sparques/mohawk/mohawk/mohawk.kicad_pcb

## KiCad design mohawk/mohawk.kicad_pcb (2026-11-03)

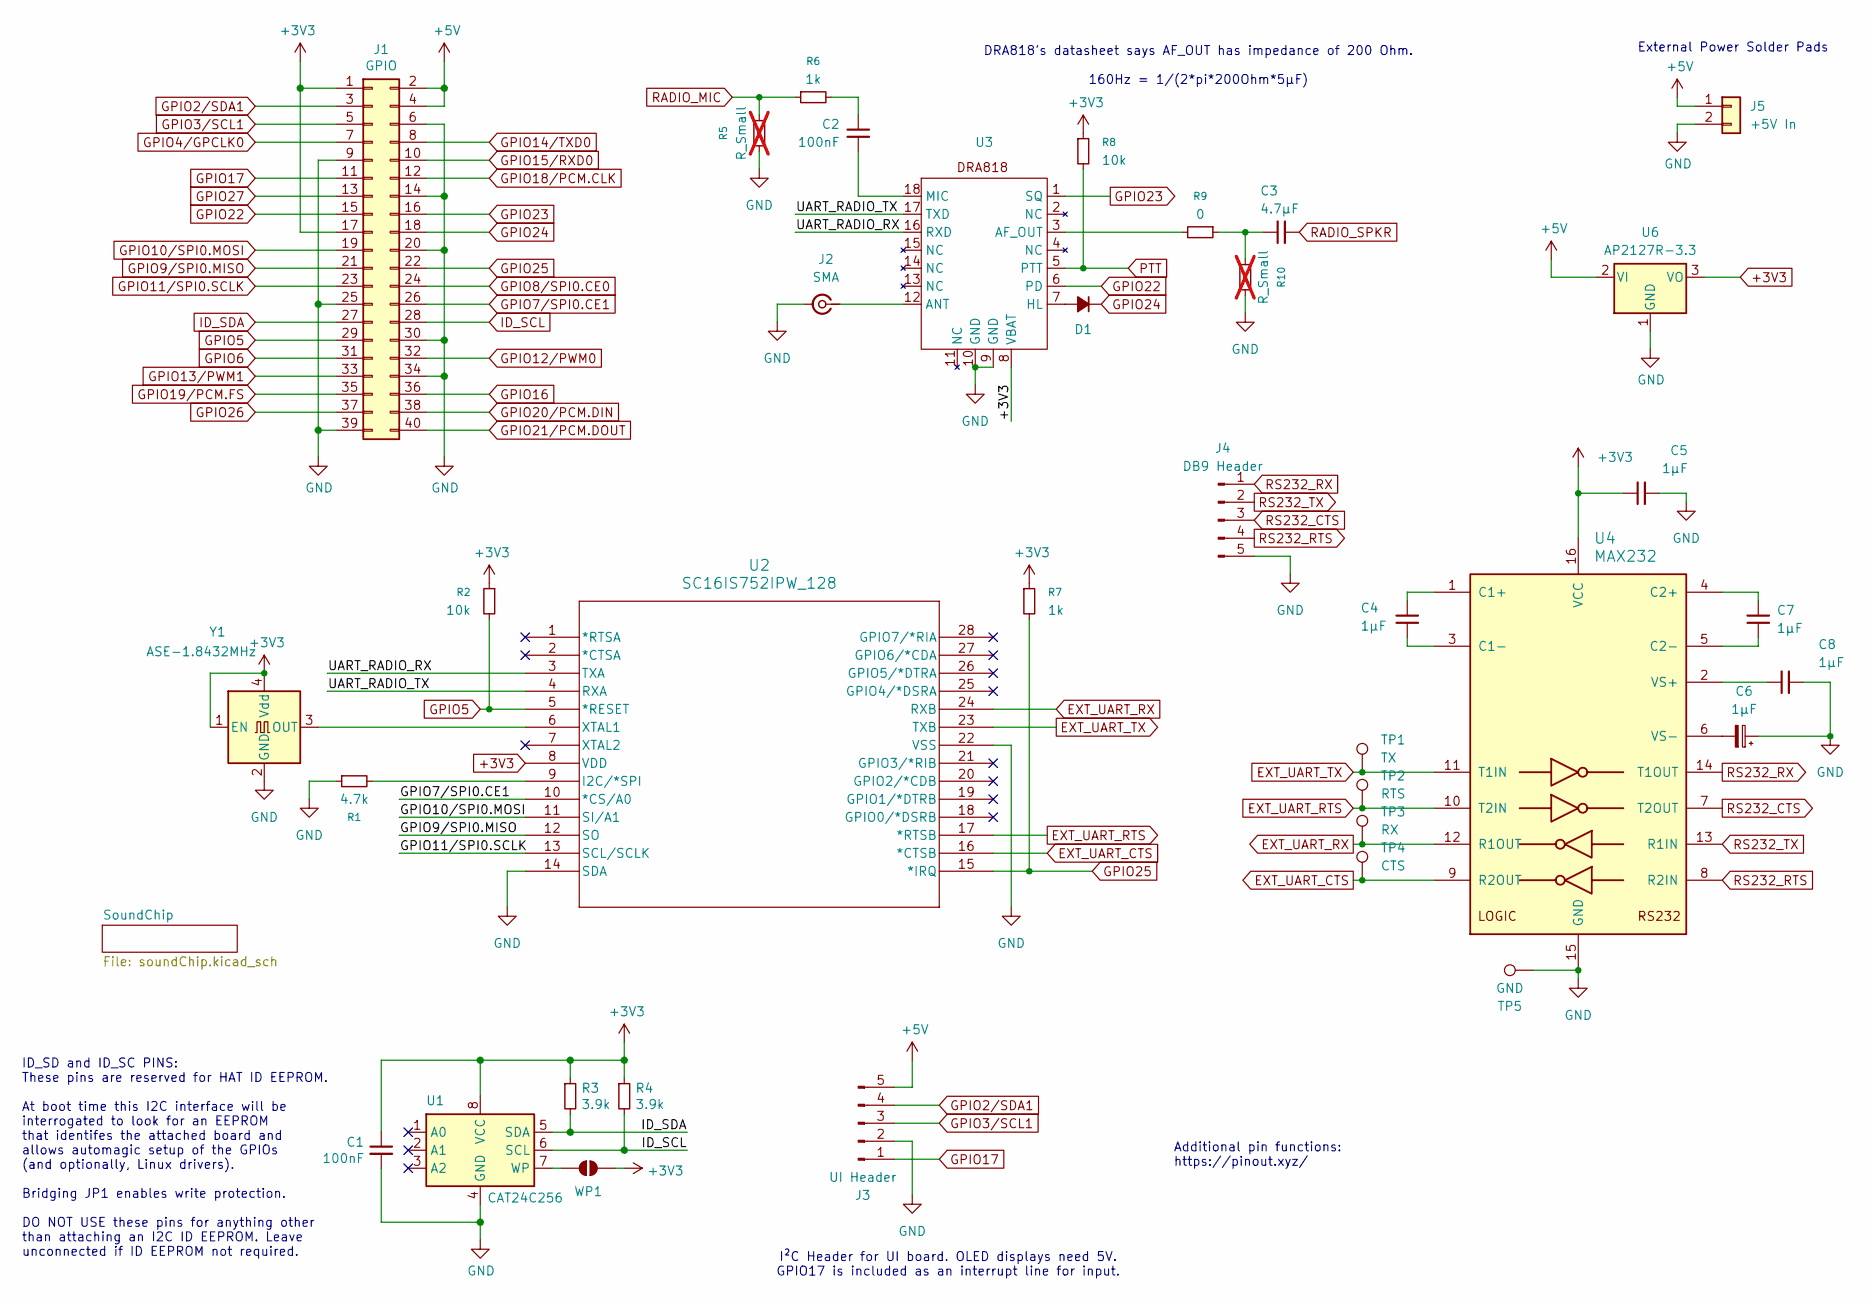
[picture p3: schematic mohawk.kicad_sch]

Parts:
C1, C2: 100nF; C_0805_2012Metric
C3: 4.7µF; C_0805_2012Metric
C4, C5, C6, C7, C8: 1µF; C_0805_2012Metric
D1: D_0805_2012Metric
J1: GPIO; PinSocket_2x20_P2.54mm_Vertical
J2: SMA; SMA_BAT_Wireless_BWSMA-KWE-Z001
J3: UI Header; 1x05 SMD pads
J4: DB9 Header; 1x05 SMD pads
J5: +5V In; SolderWirePad 1x02
R1: 4.7k; R_0805_2012Metric
R2, R8: 10k; R_0805_2012Metric
R3, R4: 3.9k; R_0805_2012Metric
R5, R10: R_Small; R_0805_2012Metric; not fitted
R6, R7: 1k; R_0805_2012Metric
R9: 0; R_0805_2012Metric
TP1: TX; TestPoint_Pad_D1.0mm
TP2: RTS; TestPoint_Pad_D1.0mm
TP3: RX; TestPoint_Pad_D1.0mm
TP4: CTS; TestPoint_Pad_D1.0mm
TP5: GND; TestPoint_Pad_D1.0mm
U1: CAT24C256; SOIC8_ONS
U2: SC16IS752IPW_128; TSSOP28_SOT361-1_NXP
U3: DRA818
U4: MAX232; PW16
U6: AP2127R-3.3; SOT-89-3
WP1: ID_WP; SolderJumper-2_P1.3mm_Open_Pad1.0x1.5mm
Y1: ASE-1.8432MHz; Oscillator_SMD_Abracon_ASE-4Pin_3.2x2.5mm

Connections:
+3V3: C1.1, C5.2, J1.1, J1.17, R2.1, R3.1, R4.1, R7.1, R8.1, U1.8 (VCC), U2.8 (VDD), U3.8 (VBAT), U4.16 (VCC), U6.3 (VO), WP1.2 (B), Y1.1 (EN), Y1.4 (Vdd); also elsewhere on the board
+5V: J1.2, J1.4, J3.5, J5.1, U6.2 (VI)
/UART_RADIO_RX: U2.3 (TXA), U3.16 (RXD)
/UART_RADIO_TX: U2.4 (RXA), U3.17 (TXD)
EXT_UART_CTS: TP4.1 (1_1), U2.16 (*CTSB), U4.9 (R2OUT)
EXT_UART_RTS: TP2.1 (1_1), U2.17 (*RTSB), U4.10 (T2IN)
EXT_UART_RX: TP3.1 (1_1), U2.24 (RXB), U4.12 (R1OUT)
EXT_UART_TX: TP1.1 (1_1), U2.23 (TXB), U4.11 (T1IN)
GND: C1.2, C5.1, C6.1, C8.2, J1.6, J1.9, J1.14, J1.20, J1.25, J1.30, J1.34, J1.39, J2.2 (Ext), J3.2, J4.5, J5.2, R1.1, R5.1, R10.1, TP5.1 (1_1), U1.4 (GND), U2.14 (SDA), U2.22 (VSS), U3.9 (GND), U3.10 (GND), U4.15 (GND), U6.1 (GND), Y1.2 (GND); also elsewhere on the board
GPIO2/SDA1: J1.3, J3.4
GPIO3/SCL1: J1.5, J3.3
GPIO4/GPCLK0: J1.7; also elsewhere on the board
GPIO5: J1.29, R2.2, U2.5 (*RESET)
GPIO6: J1.31
GPIO7/SPI0.CE1: J1.26, U2.10 (*CS/A0)
GPIO8/SPI0.CE0: J1.24; also elsewhere on the board
GPIO9/SPI0.MISO: J1.21, U2.12 (SO); also elsewhere on the board
GPIO10/SPI0.MOSI: J1.19, U2.11 (SI/A1); also elsewhere on the board
GPIO11/SPI0.SCLK: J1.23, U2.13 (SCL/SCLK); also elsewhere on the board
GPIO12/PWM0: J1.32
GPIO13/PWM1: J1.33
GPIO14/TXD0: J1.8
GPIO15/RXD0: J1.10
GPIO16: J1.36
GPIO17: J1.11, J3.1
GPIO18/PCM.CLK: J1.12; also elsewhere on the board
GPIO19/PCM.FS: J1.35; also elsewhere on the board
GPIO20/PCM.DIN: J1.38; also elsewhere on the board
GPIO21/PCM.DOUT: J1.40; also elsewhere on the board
GPIO22: J1.15, U3.6 (PD)
GPIO23: J1.16, U3.1 (SQ)
GPIO24: D1.1 (K), J1.18
GPIO25: J1.22, R7.2, U2.15 (*IRQ)
GPIO26: J1.37
GPIO27: J1.13; also elsewhere on the board
ID_SCL: J1.28, R4.2, U1.6 (SCL)
ID_SDA: J1.27, R3.2, U1.5 (SDA)
unnamed: C2.1, R6.2
unnamed: C3.1, R9.1, R10.2
unnamed: D1.2 (A), U3.7 (HL)
unnamed: J2.1 (In), U3.12 (ANT)
unnamed: U1.7 (WP), WP1.1 (A)
unnamed: R1.2, U2.9 (I2C/*SPI)
unnamed: U2.6 (XTAL1), Y1.3 (OUT)
unnamed: R9.2, U3.3 (AF_OUT)
unnamed: C2.2, U3.18 (MIC)
unnamed: C4.1, U4.1 (C1+)
unnamed: C4.2, U4.3 (C1-)
unnamed: C7.2, U4.4 (C2+)
unnamed: C7.1, U4.5 (C2-)
unnamed: C8.1, U4.2 (VS+)
unnamed: C6.2, U4.6 (VS-)
PTT: R8.2, U3.5 (PTT); also elsewhere on the board
RADIO_MIC: R5.2, R6.1; also elsewhere on the board
RADIO_SPKR: C3.2; also elsewhere on the board
RS232_CTS: J4.3, U4.7 (T2OUT)
RS232_RTS: J4.4, U4.8 (R2IN)
RS232_RX: J4.1, U4.14 (T1OUT)
RS232_TX: J4.2, U4.13 (R1IN)

Notes on the sheet:
I²C Header for UI board. OLED displays need 5V. GPIO17 is included as an interrupt line for input.
ID_SD and ID_SC PINS: These pins are reserved for HAT ID EEPROM. At boot time this I2C interface will be interrogated to look for an EEPROM that identifes the attached board and allows automagic setup of the GPIOs (and optionally, Linux drivers). Bridging JP1 enables write protection. DO NOT USE th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
DRA818's datasheet says AF_OUT has impedance of 200 Ohm. 160Hz = 1/(2*pi*200Ohm*5µF)
External Power Solder Pads
Additional pin functions: https://pinout.xyz/

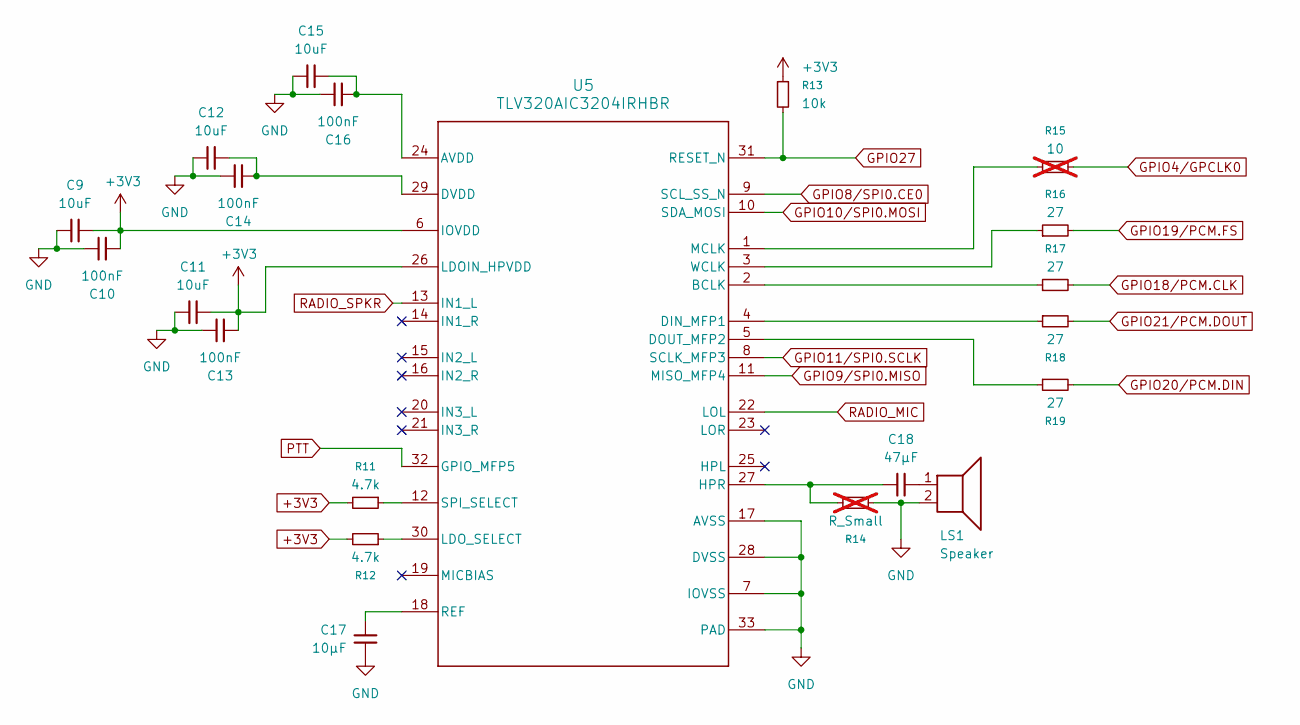
[picture p4: schematic soundChip.kicad_sch]

Parts:
C9, C11, C12, C15: 10uF; C_0805_2012Metric
C10, C13, C14, C16: 100nF; C_0805_2012Metric
C17: 10µF; C_0805_2012Metric
C18: 47µF; C_0805_2012Metric
LS1: Speaker; PinHeader_1x02_P2.54mm_Vertical
R11, R12: 4.7k; R_0805_2012Metric
R13: 10k; R_0805_2012Metric
R14: R_Small; R_0805_2012Metric; not fitted
R15: 10; R_0805_2012Metric; not fitted
R16, R17, R18, R19: 27; R_0805_2012Metric
U5: TLV320AIC3204IRHBR; RHB0032E_NV

Connections:
+3V3: C9.2, C10.2, C11.2, C13.2, R11.2, R12.2, R13.1, U5.6 (IOVDD), U5.26 (LDOIN_HPVDD); also elsewhere on the board
GND: C9.1, C10.1, C11.1, C12.1, C13.1, C14.1, C15.1, C16.1, C17.2, LS1.2, R14.2, U5.7 (IOVSS), U5.17 (AVSS), U5.28 (DVSS), U5.33 (PAD); also elsewhere on the board
GPIO4/GPCLK0: R15.2; also elsewhere on the board
GPIO8/SPI0.CE0: U5.9 (SCL_SS_N); also elsewhere on the board
GPIO9/SPI0.MISO: U5.11 (MISO_MFP4); also elsewhere on the board
GPIO10/SPI0.MOSI: U5.10 (SDA_MOSI); also elsewhere on the board
GPIO11/SPI0.SCLK: U5.8 (SCLK_MFP3); also elsewhere on the board
GPIO18/PCM.CLK: R17.2; also elsewhere on the board
GPIO19/PCM.FS: R16.2; also elsewhere on the board
GPIO20/PCM.DIN: R19.2; also elsewhere on the board
GPIO21/PCM.DOUT: R18.2; also elsewhere on the board
GPIO27: R13.2, U5.31 (RESET_N); also elsewhere on the board
unnamed: C18.2, LS1.1
unnamed: C15.2, C16.2, U5.24 (AVDD)
unnamed: R17.1, U5.2 (BCLK)
unnamed: R18.1, U5.4 (DIN_MFP1)
unnamed: R19.1, U5.5 (DOUT_MFP2)
unnamed: C12.2, C14.2, U5.29 (DVDD)
unnamed: C18.1, R14.1, U5.27 (HPR)
unnamed: R12.1, U5.30 (LDO_SELECT)
unnamed: R15.1, U5.1 (MCLK)
unnamed: C17.1, U5.18 (REF)
unnamed: R11.1, U5.12 (SPI_SELECT)
unnamed: R16.1, U5.3 (WCLK)
PTT: U5.32 (GPIO_MFP5); also elsewhere on the board
RADIO_MIC: U5.22 (LOL); also elsewhere on the board
RADIO_SPKR: U5.13 (IN1_L); also elsewhere on the board

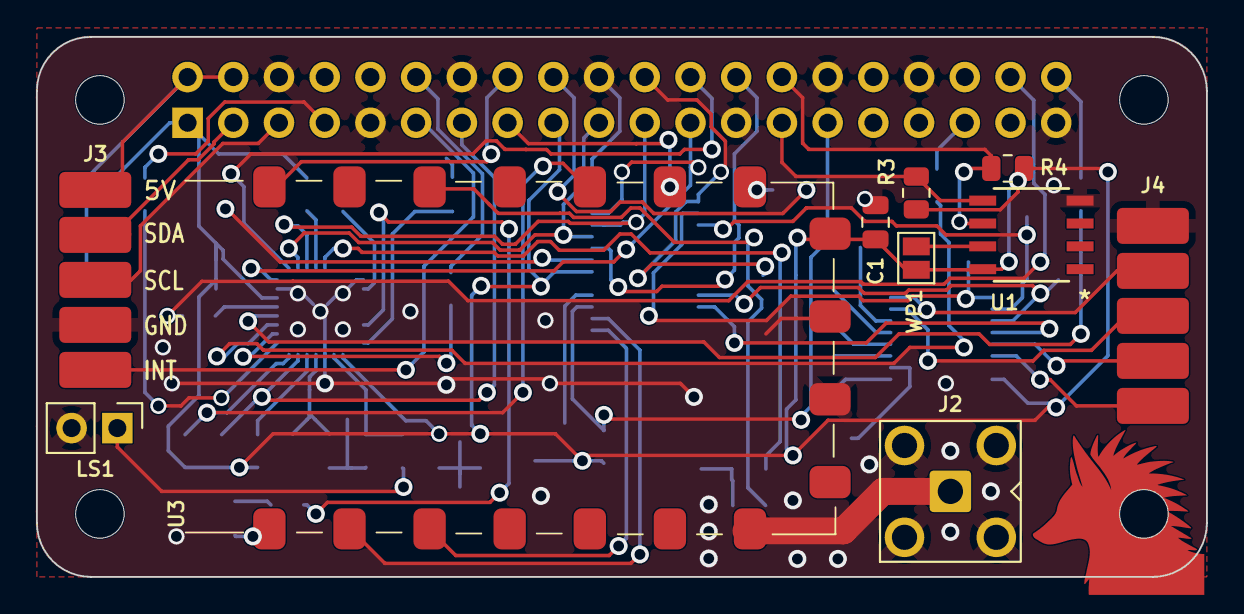
[picture p5: board mohawk.kicad_pcb from above]

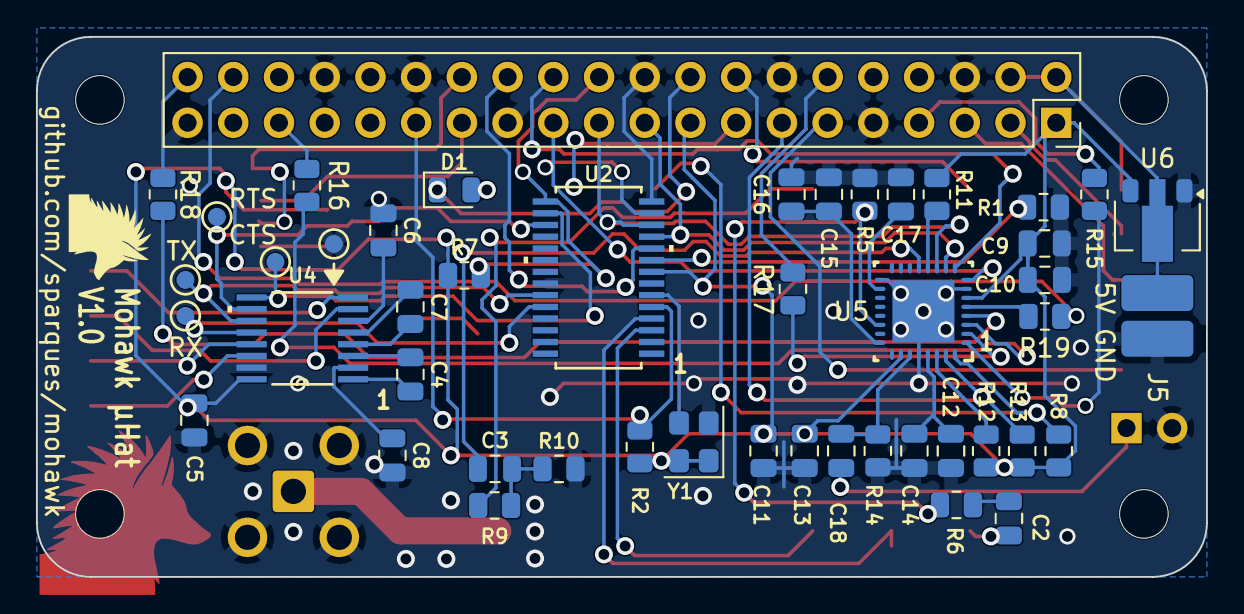
[picture p6: board mohawk.kicad_pcb from below]

Board: 2 copper layers, 65.0 x 30.0 mm, 61 parts (47 on the bottom side), 64 nets.

Other parts of the board:
MH1, MH2, MH3, MH4: MountingHole_2.7mm_M2.5
