sparques/mohawk/(commit log)

2026-10-28 clean up traces; add missing serial resistors for I²S lines
    [mohawk.kicad_pcb, soundChip.kicad_sch]
2026-10-29 routing cleanups / add renders
    [mohawk.kicad_pcb]
2026-10-31 more routing clean up; add external power solder pads, add Makefile
    [mohawk.kicad_pcb, mohawk.kicad_sch]
2026-10-31 add model for SMA connector and regenerate renders
    [mohawk.kicad_pcb]
2026-10-31 add test points for EXT_UART; add 3d model for oscillator
    [mohawk.kicad_pcb, mohawk.kicad_sch]
2026-10-31 Fix DRA818 foot print; addres DRC errors
    [mohawk.kicad_pcb]
2026-11-01 more pointless routing clean up
    [mohawk.kicad_pcb]
2026-11-02 fix SPI addresses
2026-11-03 update datasheet / add LDO footprint / update renders
    [mohawk.kicad_pcb, mohawk.kicad_sch]
2026-11-03 added devicetree overlay
2026-11-10 shift TP locations around on schematic
    [mohawk.kicad_sch]
2026-11-14 fix (reverse) H/L select diode
    [mohawk.kicad_sch]
2026-11-14 Revert "fix (reverse) H/L select diode"
    This reverts commit 856cee964715a83606eb0f91bf77452023b4571b.
    [mohawk.kicad_sch]
